MarkLundager/FRTN85-Pproject-Group6/scripts/inverse_kinematics/imgs/axis_convenction.png

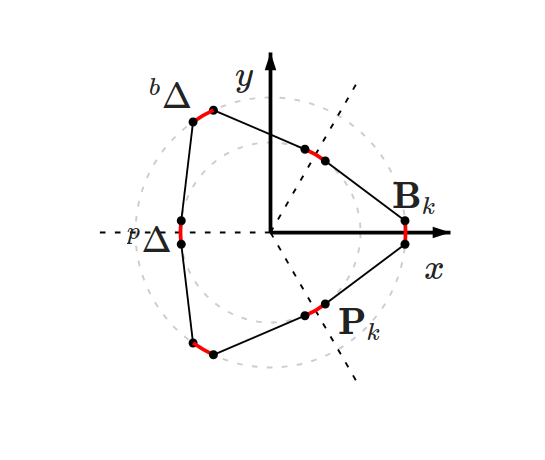
scripts/inverse_kinematics/imgs/axis_convenction.png
