MarkLundager/FRTN85-Pproject-Group6/scripts/inverse_kinematics/imgs/measurements.png

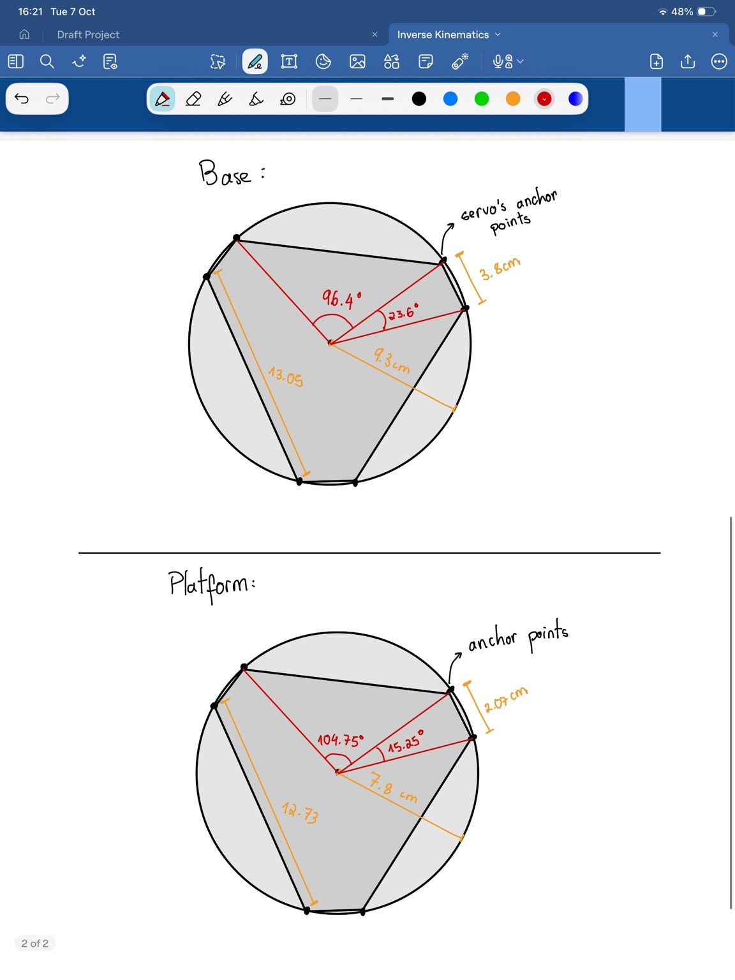
scripts/inverse_kinematics/imgs/measurements.png
