MarkLundager/FRTN85-Pproject-Group6/arduino/testing/motors_test/motors_test.ino

#include <Servo.h>

Servo servo1;
Servo servo2;
Servo servo3;
Servo servo4;
Servo servo5;
Servo servo6;

int pos = 0;

void setup() {
  servo1.attach(9);   // Original servo
  servo2.attach(8);
  servo3.attach(10);
  servo4.attach(11);
  servo5.attach(12);
  servo6.attach(13);
}

void loop() {
  // Sweep from 0 to 180
  for (pos = 0; pos <= 180; pos++) {
    servo1.write(pos);
    servo2.write(pos);
    servo3.write(pos);
    servo4.write(pos);
    servo5.write(pos);
    servo6.write(pos);
    delay(15);
  }

  // Sweep from 180 back to 0
  for (pos = 180; pos >= 0; pos--) {
    servo1.write(pos);
    servo2.write(pos);
    servo3.write(pos);
    servo4.write(pos);
    servo5.write(pos);
    servo6.write(pos);
    delay(15);
  }
}
