MarkLundager/FRTN85-Pproject-Group6/(commit log)

2025-10-07 main file for the arduino controller. Still empty
2025-10-07 script to use gyroscope and accelerometer combined with a complementary filter, to calculate the pitch and the roll of the IMU
2025-10-07 script to use the magnetometer, gyroscope and accelerometer, combined with a kalman filter, to calculate the yaw, pitch and roll of the IMU (too shaky, doesn't work well)
    [yaw_pitch_roll.ino]
2025-10-07 script to use in the "processing" app to view 3D animation of the IMU pitch and roll
2025-10-07 script to use in the "processing" app to view 3D animation of the IMU yaw, pitch and roll
2025-10-07 inverse kinematics script and visualization
2025-10-08 added motors testing script
2025-10-08 added inverse kinematics in cpp to the real platform
2025-10-22 simulator updates, fixed FK
    [controller.cpp, controller.h, controller_test.ino, fk.h, geometry.h, ik.cpp]
2025-10-23 organized arduino dir
